KankonNil007/ECE-2104-KUET/(list of files, drawings)

Other design files:
simulation/ECE-2104-Project.ms14
